Wriju-Mitra/Opto-Box-v2/Components.xlsx

# | Item | Qty
1 | Arduino Uno r3 | 1
2 | WS2812B straight 8 LED module | 20
3 | DC-DC 3A 5V-12V to, 5V Step-down Power, Supply Module | 1
4 | Barrell Jack 2.2x5.5 Female
5 | Countersunk Philips Head M3 X 10 mm Screw | 4
6 | M3 nut | 4
7 | Philips Head countersunk M4 X 12 mm screw | 8
8 | M4 nut | 4
9 | M4 X 4 mm Brass Heat set Threaded Round Insert Nut | 4
10 | 1N5822 Schottky diode (SR560, DR150,etc will also work. A 1N4007 will also work just fine) | 1
11 | 9v-12V 2A DC power supply | 1
12 | Male to female jumper wires
13 | 3mm LED in 3 different colors preferably | 3
14 | 5V piezo buzzer | 1
15 | 1N2222A transistor
16 | 1K resistor | 2
17 | Male header pins
18 | Screw terminal blocks 2 pin | 1
19 | Screw terminal blocks 3 pin | 1
20 | Perfboard
21 | 30AWG wire
22 | 22 or 24 AWG wire
23 | 5V DC fan 30x30x8mm | 1
