Wriju-Mitra/Opto-Box-v2/Images/20240924_175607.jpg

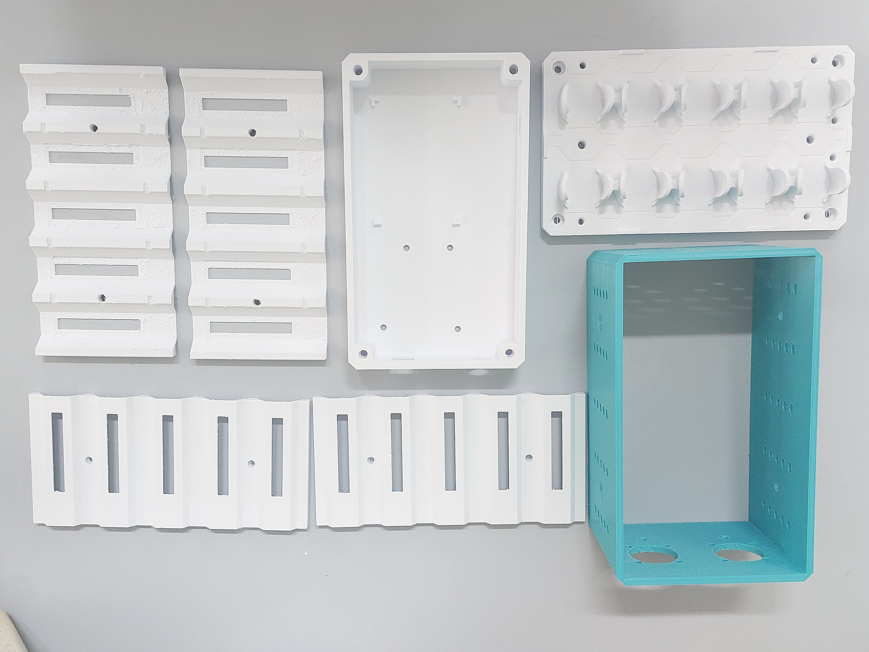
Images/20240924_175607.jpg
