Wriju-Mitra/Opto-Box-v2/Images/20240925_201229.jpg

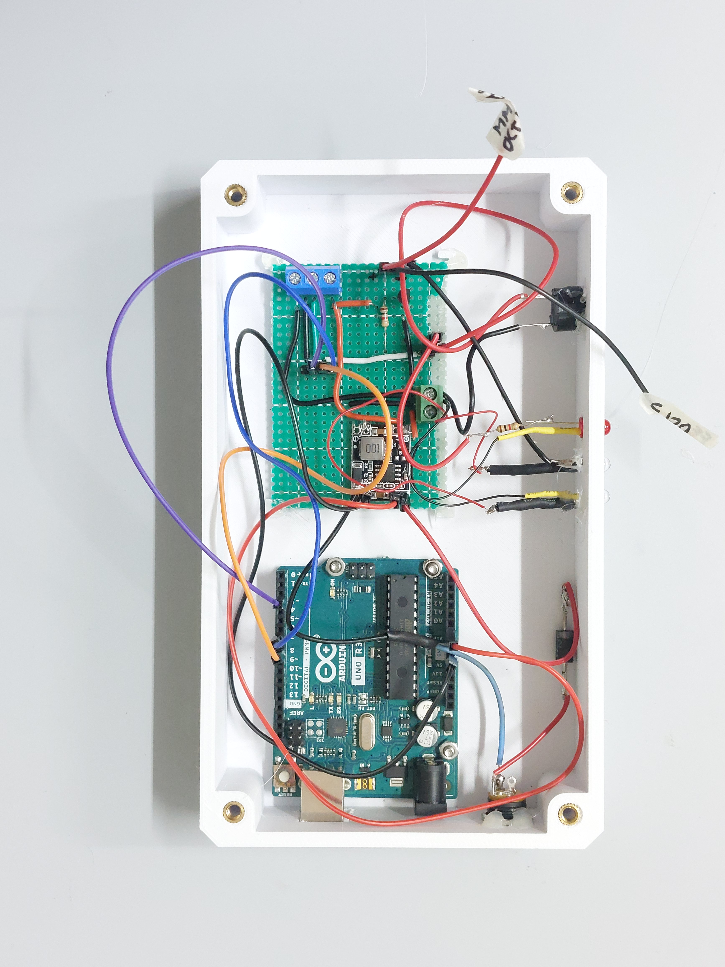
Images/20240925_201229.jpg
