Wriju-Mitra/Opto-Box-v2/Images/20240927_150941.jpg

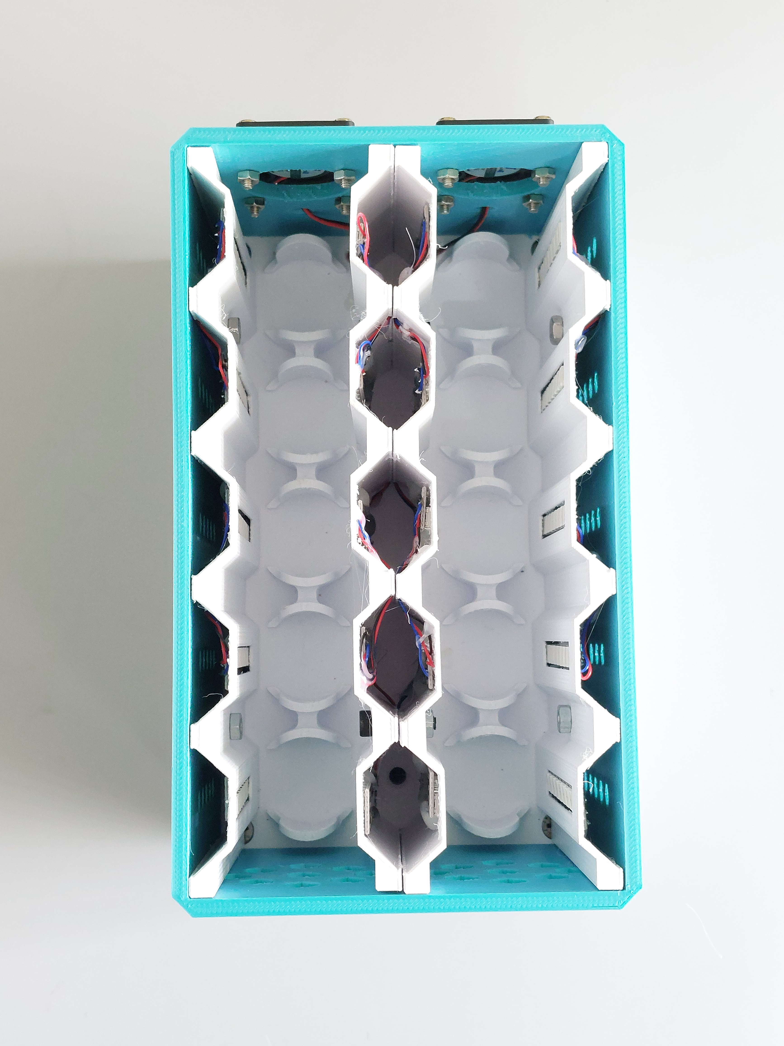
[picture p2: Images/20240927_150941.jpg]
Images/20240927_150941.jpg
